phorton1/Arduino-wireStripper32/docs/design.md

# wireStripper32 - Design

**[Home](readme.md)** --
**Design** --
**[Electronics](electronics.md)** --
**[Build](build.md)** --
**[Firmware](firmware.md)** --

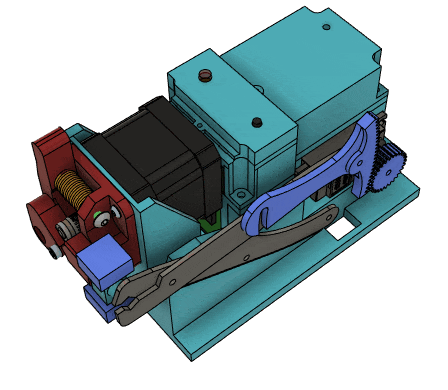
[picture p2: docs/images/design_anim1.gif]
design_anim1


**Next:** A look at the [**Electronics**](electronics.md) for the machine ...
