phorton1/Arduino-wireStripper32/docs/electronics.md

# wireStripper32 - Electronics

**[Home](readme.md)** --
**[Design](design.md)** --
**Electronics** --
**[Build](build.md)** --
**[Firmware](firmware.md)** --

This page shows all of the schematics, PCB designs, and has
photos of the completed circuit boards used in the wireStripper.
Please see the **/docs/kicad** folder for the actual schematics
and PCB designs.

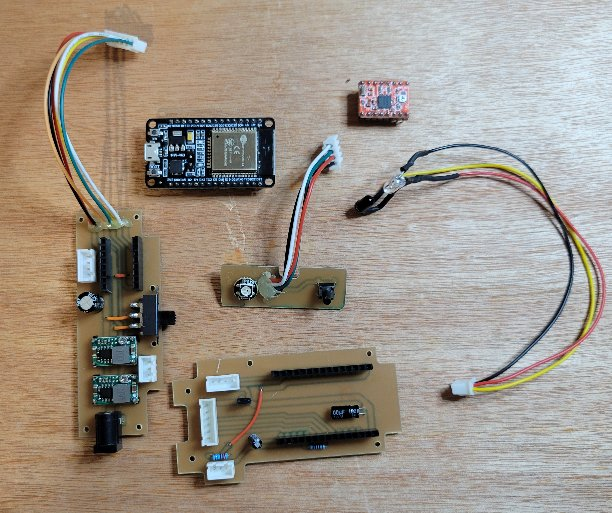
[picture p3: docs/images/electronics.jpg]


## The Power Board

The *Power Board* takes a **12V DC** input and has two **buck converters* on it.
One buck converter produces **7V DC** (the maximum rated voltage) for the
Servo and the other convertor produces **5V** DC to go to the ESP32.
The Power Board has a **scocket** for the *A4988 stepper motor controller**,
and **plugs** for the *Nema17 stepper motor* and *MG995 Servo*.
The Power Board connects to the Main Board with a **6 pin cable** that
caries GND, 5V, the **Enable, Step, and Direction** signals for
the stepper motor, and the PWM signal for the *Servo*.

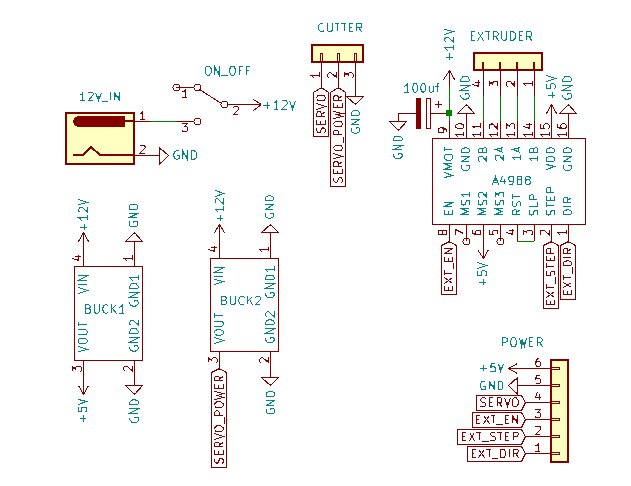
[picture p4: docs/images/elec_power_schematic.jpg]

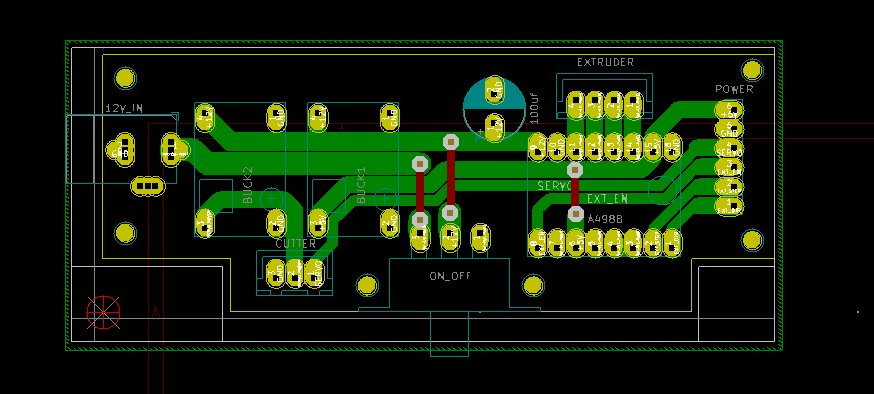
[picture p5: docs/images/elec_power_pcb.jpg]

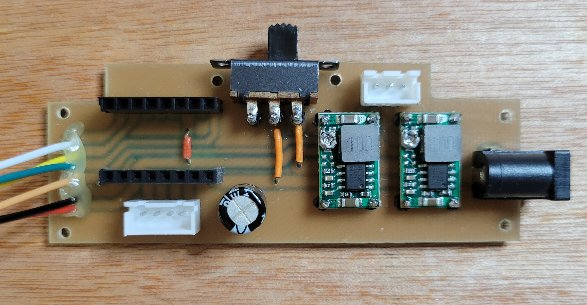
[picture p6: docs/images/elec_power_front.jpg]

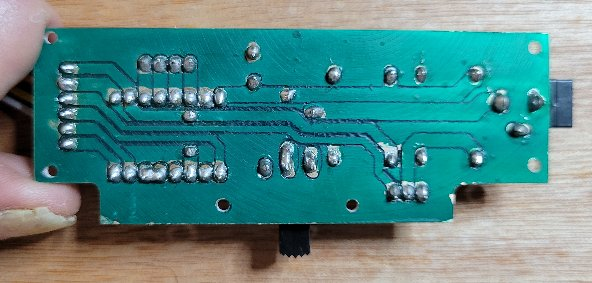
[picture p7: docs/images/elec_power_back.jpg]


## The Main Board

The *Main Board* has a **socket** for the ESP32 dev board, and
**plugs** to connect it to the *Power Board*, the *IR Sensor*
LEDs, and the **UI Board**.   It also has a **jumper** that
allows the ESP32 to connect the **5V** from Power Board to the
*VIN pin* on the ESP32, along with a 100uf capacitor to smooth
out the 5V VIN power supply

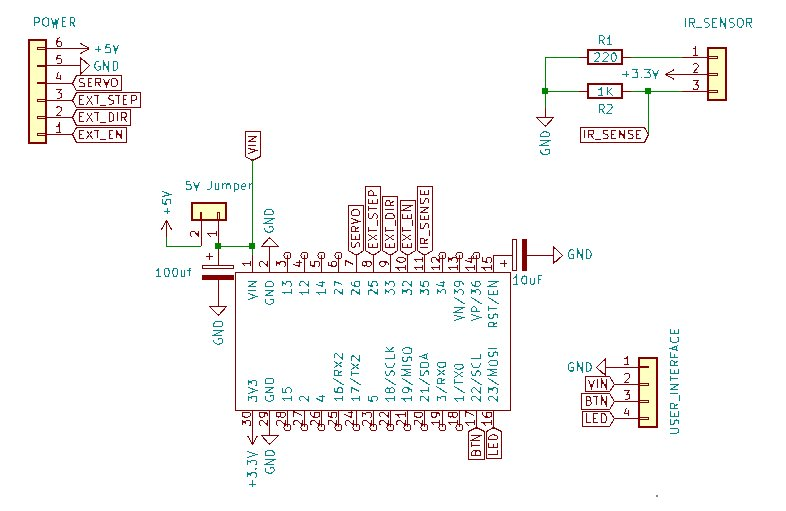
[picture p8: docs/images/elec_board_schematic.jpg]

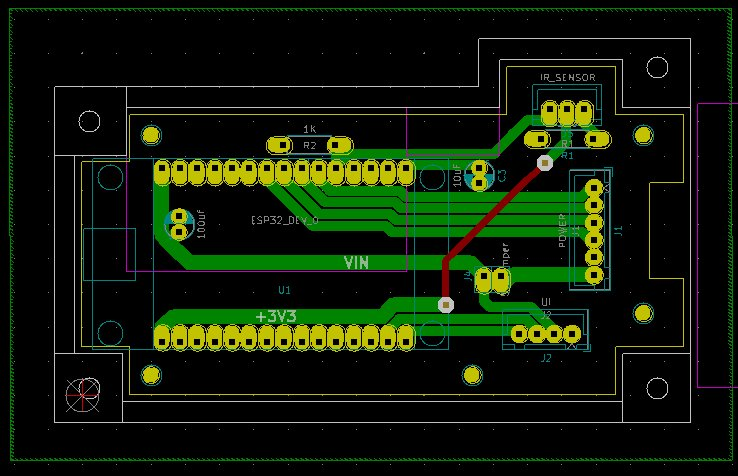
[picture p9: docs/images/elec_board_pcb.jpg]

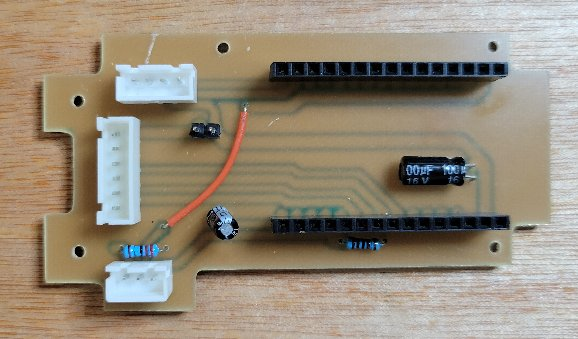
[picture p10: docs/images/elec_board_front.jpg]

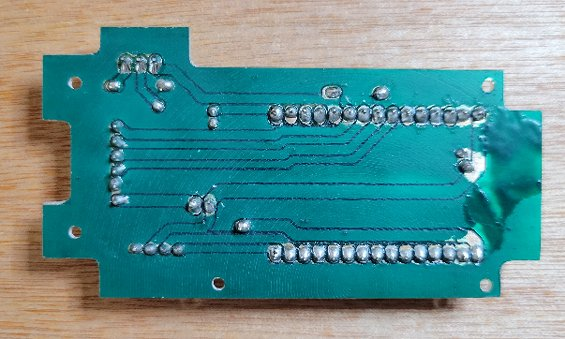
[picture p11: docs/images/elec_board_back.jpg]


## The UI (User Interface) Board

The UI board simply has a **push button** and a **WS2812b LED**
on it, along with a cable that reaches to the Main Board.

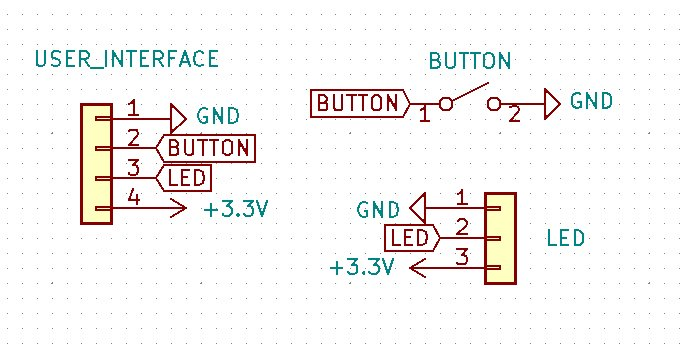
[picture p12: docs/images/elec_ui_schematic.jpg]

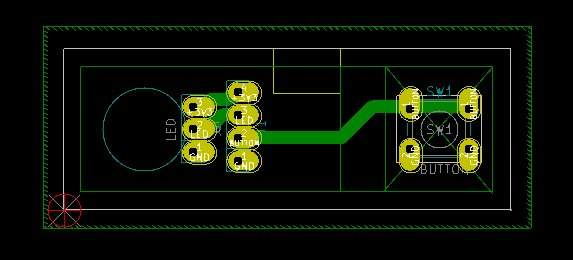
[picture p13: docs/images/elec_ui_pcb.jpg]

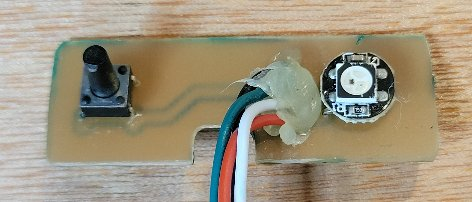
[picture p14: docs/images/elec_ui_front.jpg]

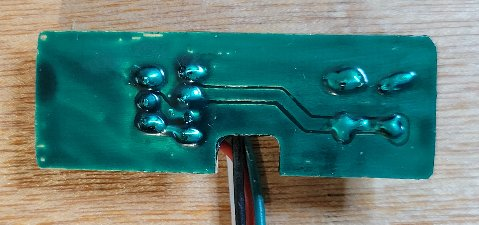
[picture p15: docs/images/elec_ui_back.jpg]


I used a 9mm circular WS2812b breakout board for the LED:

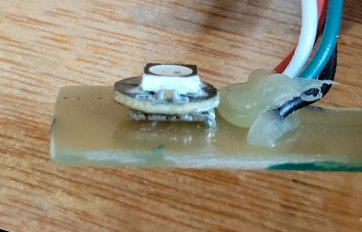
[picture p16: docs/images/elec_led_detail.jpg]


## The IR Sensor

The IR Sensor merely consists of an **850nm** *LED* (clear)
and *sensor* (black), soldered directly to a 3 pin JST wire
header with some heat shrink tubing.

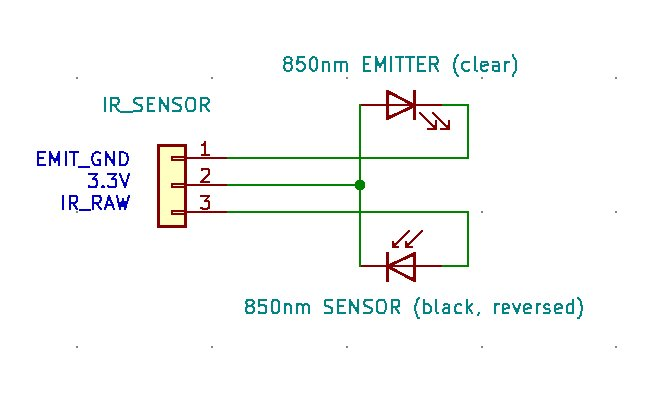
[picture p17: docs/images/elec_ir_schematic.jpg]

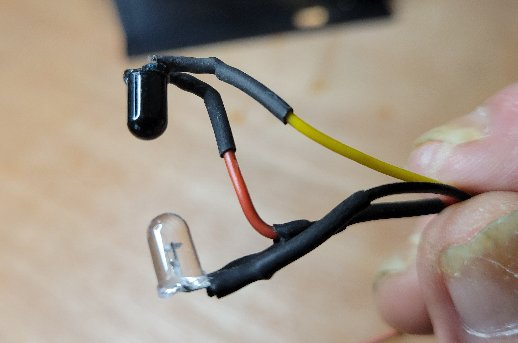
[picture p18: docs/images/elec_ir_sensor.jpg]


The key is that the **LED is wired normally** with the anode
(the long leg) to the 3.3V power supply, but **the Sensor is
wired backwards** with the cathode (the short leg) connected
to the 3.3V power supply.

## Other Cables/Connectors

I also put a 4-pin JST connector on the end of a short standard
stepper motor cable,

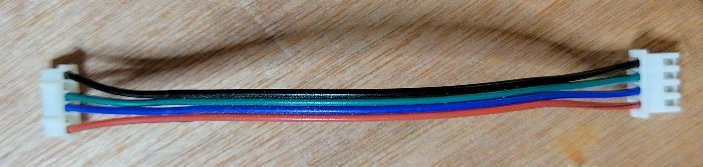
[picture p19: docs/images/elec_stepper_cable.jpg]


and added a 3-pin JST connector to the (shorted) cable on the
Servo.

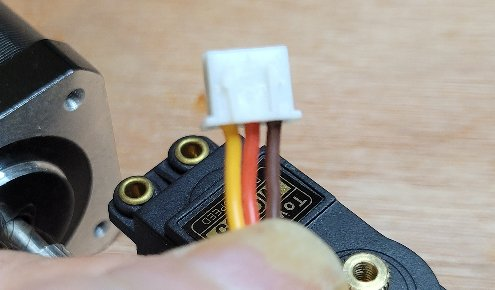
[picture p20: docs/images/elec_servo_connector.jpg]


**Next:** - [**Building**](building.md) the wireStripper ..
