phorton1/Arduino-wireStripper32/docs/fusion/lens.stl

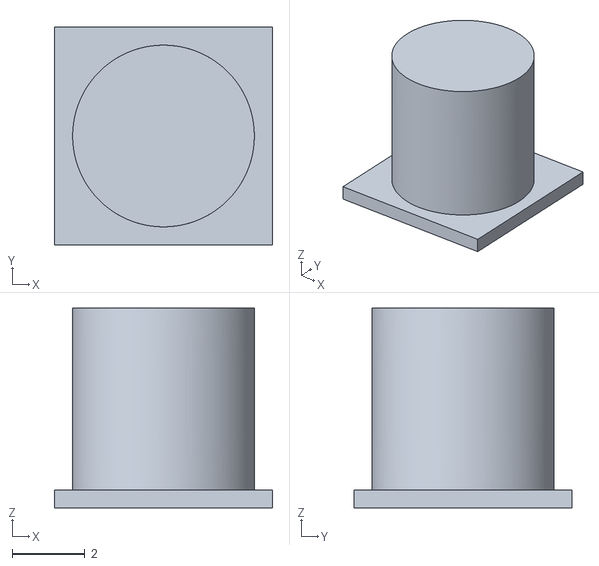
[picture p21: CAD file, 2024-07-24]
docs/fusion/lens.stl
6.00 x 6.00 x 5.50
