phorton1/Arduino-wireStripper32/docs/kicad/ui_board/ui_board.step

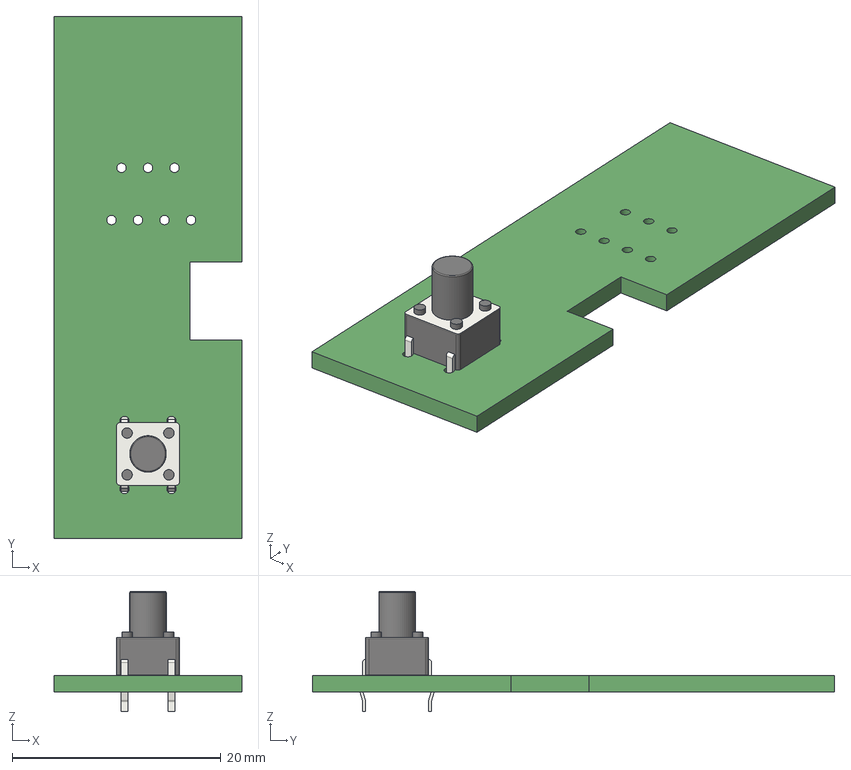
[picture p22: CAD file, 2024-07-24]
docs/kicad/ui_board/ui_board.step
18.0 x 50.0 x 11.5 mm
