phorton1/Arduino-wireStripper32/docs/prusa/top.3mf

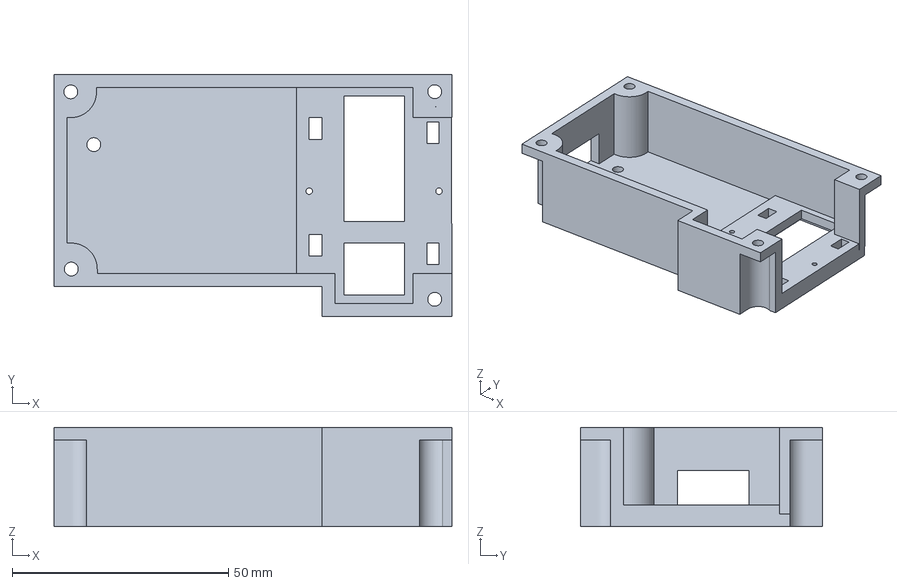
[picture p23: CAD file, 2024-07-24]
docs/prusa/top.3mf
92.0 x 56.0 x 23.0 mm
