phorton1/Arduino-wireStripper32/docs/fusion/frame.stl

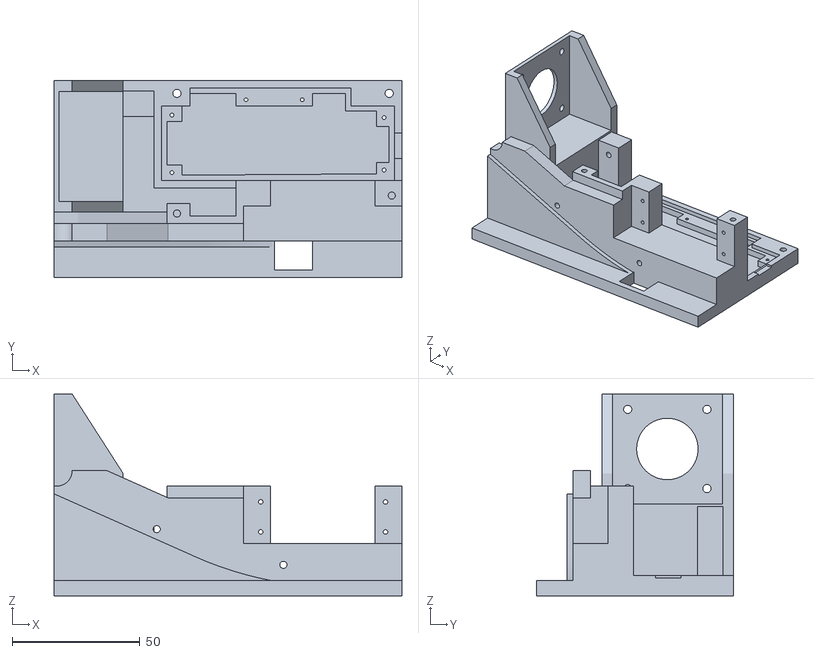
[picture p24: CAD file, 2024-07-24]
docs/fusion/frame.stl
136.1 x 77.0 x 79.0
