phorton1/Arduino-wireStripper32/docs/prusa/ui_top.3mf

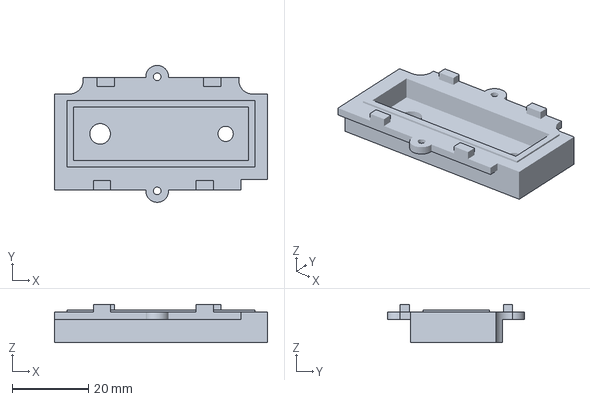
[picture p25: CAD file, 2024-07-24]
docs/prusa/ui_top.3mf
56.0 x 35.9 x 10.0 mm
