phorton1/Arduino-wireStripper32/docs/fusion/cap.stl

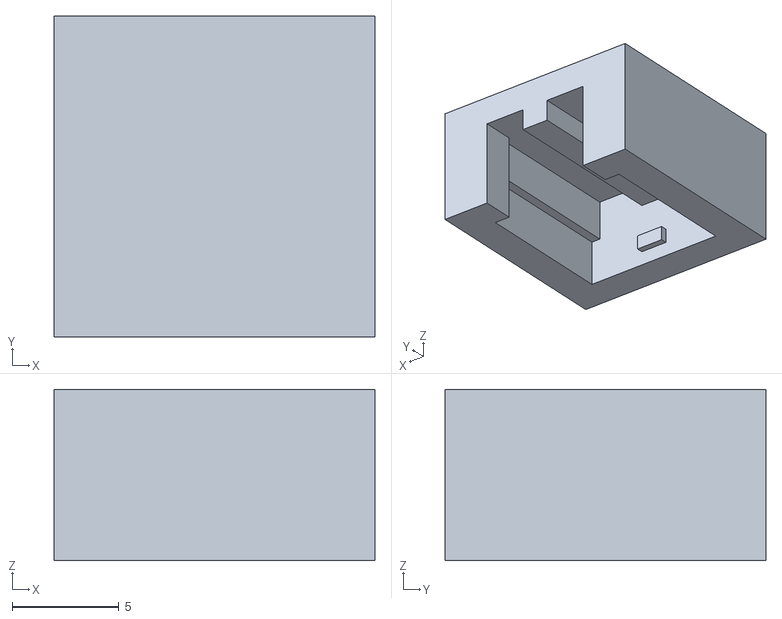
[picture p26: CAD file, 2024-07-24]
docs/fusion/cap.stl
15.0 x 15.0 x 8.00
