phorton1/Arduino-wireStripper32/docs/fusion/gear2.stl

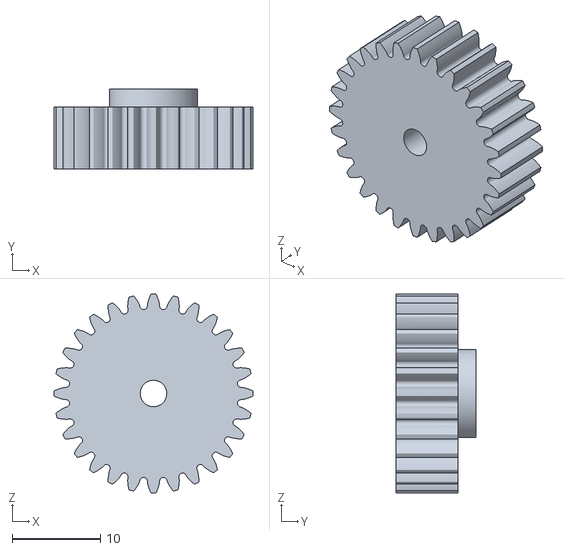
[picture p27: CAD file, 2024-07-24]
docs/fusion/gear2.stl
22.5 x 9.00 x 22.5
