phorton1/Arduino-wireStripper32/docs/prusa/lens.3mf

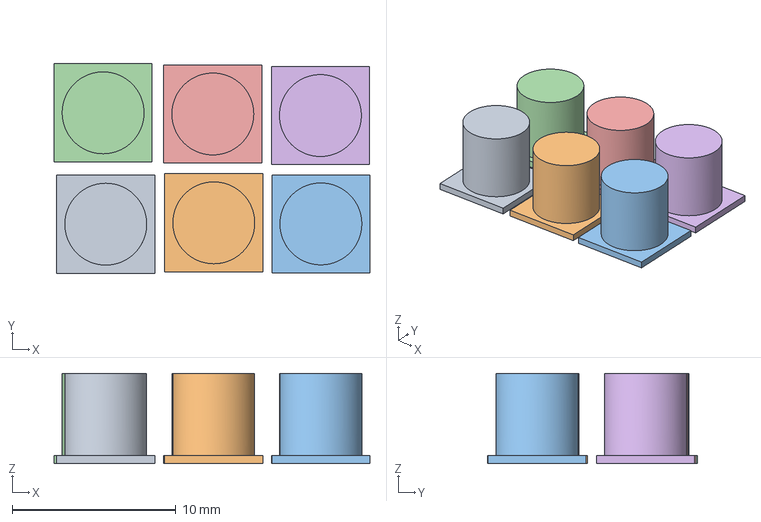
[picture p28: CAD file, 2024-07-24]
docs/prusa/lens.3mf
19.3 x 12.8 x 5.50 mm
lens.stl x 6
