phorton1/Arduino-wireStripper32/docs/fusion/middle.stl

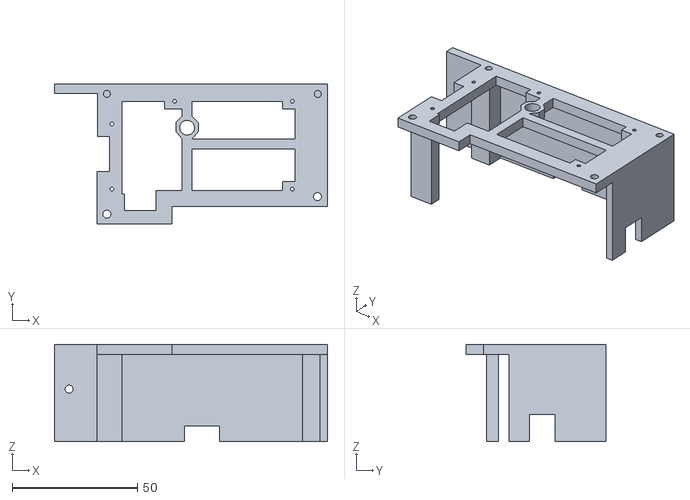
[picture p29: CAD file, 2024-07-24]
docs/fusion/middle.stl
108.9 x 56.0 x 38.8
