phorton1/Arduino-wireStripper32/docs/prusa/gear1.3mf

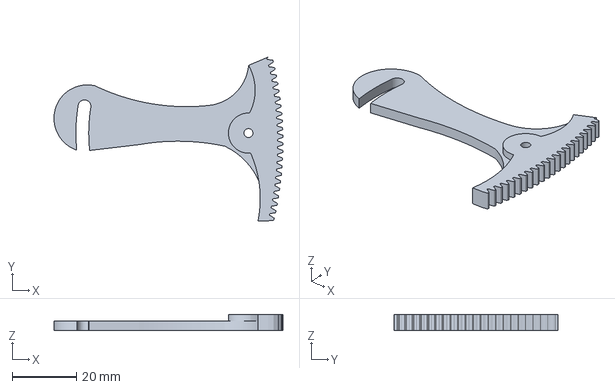
[picture p30: CAD file, 2024-07-24]
docs/prusa/gear1.3mf
71.5 x 51.1 x 5.00 mm
