phorton1/Arduino-wireStripper32/docs/prusa/cap.3mf

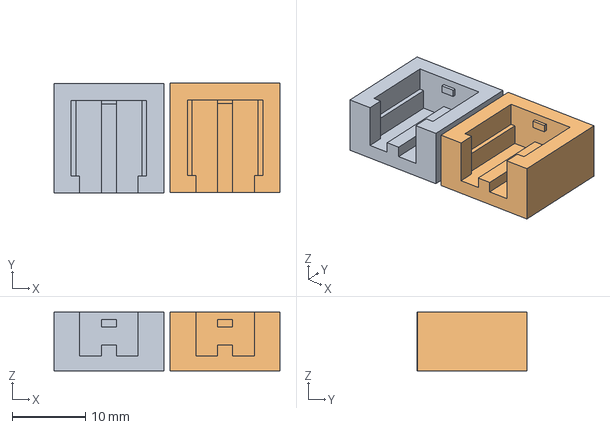
[picture p31: CAD file, 2024-07-24]
docs/prusa/cap.3mf
30.9 x 15.1 x 8.00 mm
cap.stl x 2
