phorton1/Arduino-wireStripper32/docs/prusa/nozzle.3mf

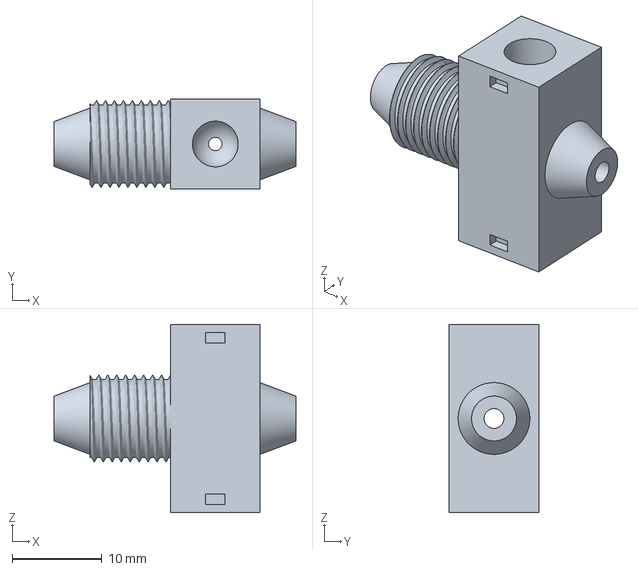
[picture p32: CAD file, 2024-07-24]
docs/prusa/nozzle.3mf
27.0 x 10.0 x 21.0 mm
