phorton1/Arduino-wireStripper32/(list of files, cad)

Other CAD files:
docs/prusa/frame.3mf
docs/fusion/gear1.stl
docs/fusion/ui_top.stl
docs/prusa/gear2.3mf
docs/fusion/top.stl
docs/fusion/nozzle.stl
docs/prusa/middle.3mf
