phorton1/Arduino-wireStripper32/docs/build.md

# wireStripper32 - Building the wireStripper

**[Home](readme.md)** --
**[Design](design.md)** --
**[Electronics](electronics.md)** --
**Build** --
**[Firmware](firmware.md)** --

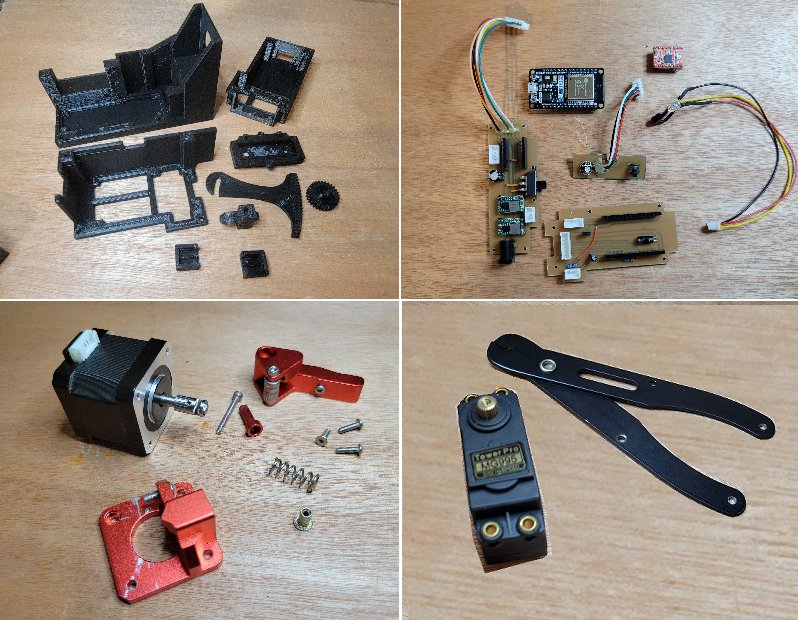
[picture p33: docs/images/build_combined.jpg]


**Next:** Installing the **[Firmware](firmware.md)** and testing the PCB ...
