phorton1/Arduino-wireStripper32/docs/kicad/power/power.kicad_pcb

## KiCad design docs/kicad/power/power.kicad_pcb (2024-07-27)

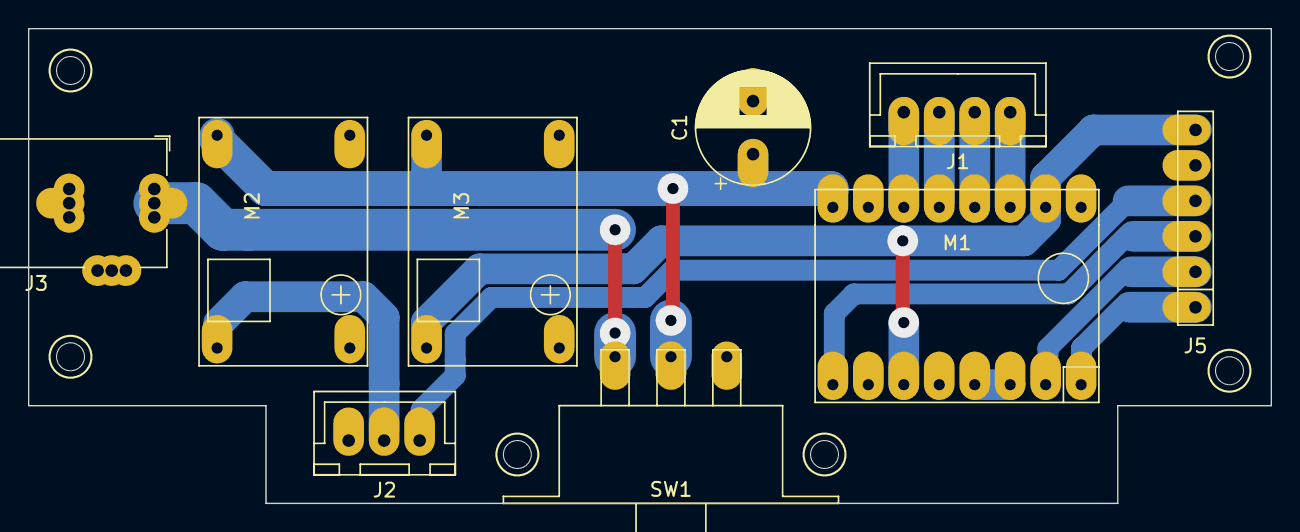
[picture p34: board power.kicad_pcb from above]

Board: 2 copper layers, 89.0 x 34.0 mm, 9 parts (0 on the bottom side), 14 nets.

Parts:
C1: 100uf; CP_my100uf
J1: EXTRUDER; JST4
J2: CUTTER; JST3
J3: 12V_IN; myBarrelJack
J5: POWER; myPinSocket_1x06
M1: A4988; a498
M2: BUCK2; buck-mini360
M3: BUCK1; buck-mini360
SW1: ON_OFF; slide_switch_big_right

Connections:
+5V: J5.6, M1.6, M1.15, M3.3
+12V: C1.1, M1.9, M2.4, M3.4, SW1.2
EXT_DIR: J5.1, M1.1
EXT_EN: J5.3, M1.8
EXT_STEP: J5.2, M1.2
GND: C1.2, J2.3, J3.2, J5.5, M1.10, M1.16, M2.1, M2.2, M3.1, M3.2
unnamed: J1.1, M1.14
unnamed: J1.2, M1.13
unnamed: J1.3, M1.12
unnamed: J1.4, M1.11
unnamed: J3.1, SW1.3
unnamed: M1.3, M1.4
SERVO: J2.1, J5.4
SERVO_POWER: J2.2, M2.3
