phorton1/Arduino-wireStripper32/docs/kicad/ui_board/ui_board.kicad_pcb

## KiCad design docs/kicad/ui_board/ui_board.kicad_pcb (2024-07-27)

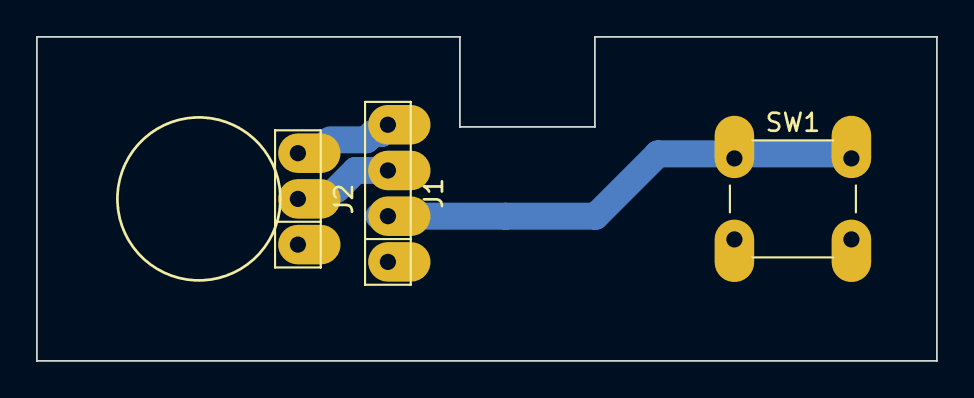
[picture p35: board ui_board.kicad_pcb from above]

Board: 2 copper layers, 50.0 x 18.0 mm, 3 parts (0 on the bottom side), 4 nets.

Parts:
J1: UI; my4pin
J2: LED; my3pin
SW1: BUTTON; SW_PUSH_6mm_H8mm

Connections:
+3V3: J1.4, J2.3
BUTTON: J1.2, SW1.1
GND: J1.1, J2.1, SW1.2
LED: J1.3, J2.2
