phorton1/Arduino-wireStripper32/docs/kicad/board/board.kicad_pcb

## KiCad design docs/kicad/board/board.kicad_pcb (2024-07-24)

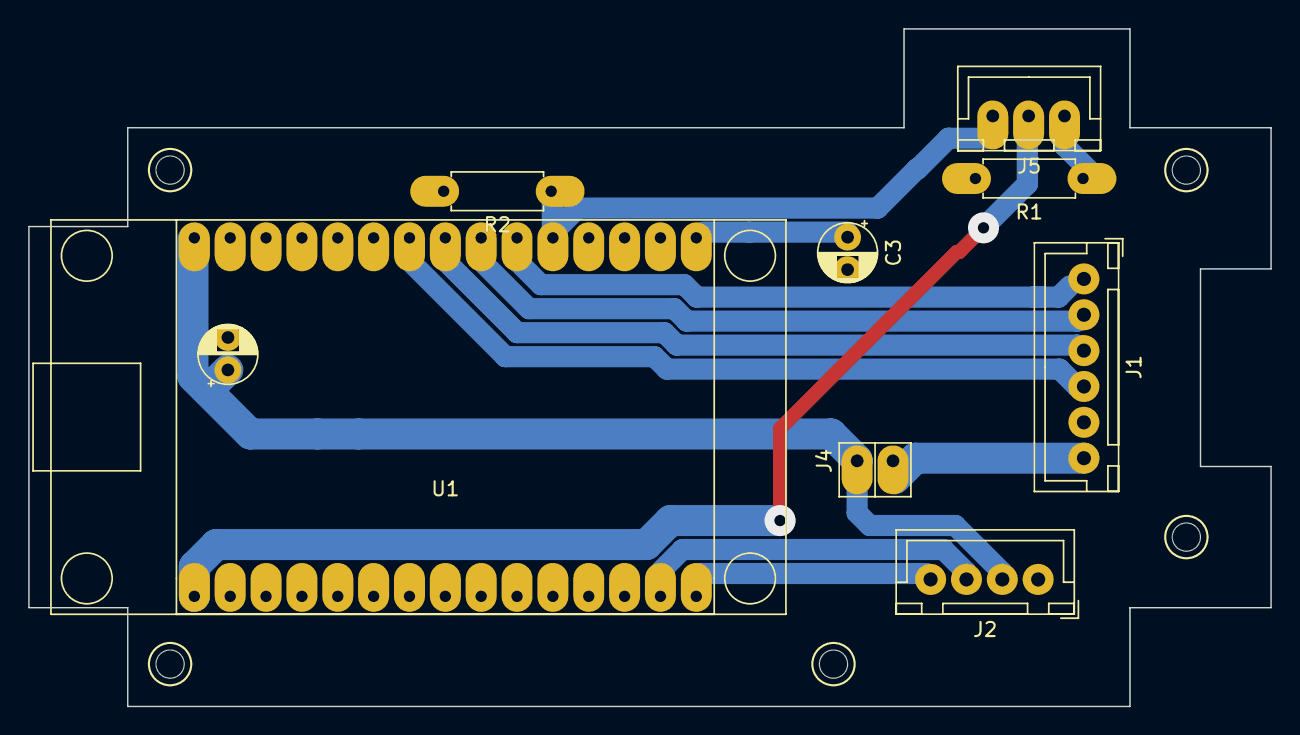
[picture p36: board board.kicad_pcb from above]

Board: 2 copper layers, 88.0 x 48.0 mm, 9 parts (0 on the bottom side), 13 nets.

Parts:
C2: 100uf; CP_my10uf
C3: 10uF; CP_my10uf
J1: POWER; myJSTx06
J2: UI; myJSTx04
J4: 5V Jumper; pinHeader1x2
J5: IR_SENSOR; JST3
R1: 220; resistor
R2: 1K; resistor
U1: ESP32_DEV_0; esp32_dev_0

Connections:
+3V3: J5.2, U1.30
+5V: J1.6, J4.2
BTN: J2.3, U1.17
EXT_DIR: J1.2, U1.9
EXT_EN: J1.1, U1.10
EXT_STEP: J1.3, U1.8
GND: C2.2, C3.2, J1.5, J2.1, R1.2, R2.2, U1.2, U1.29
IR_SENSE: J5.3, R2.1, U1.11
LED: J2.4, U1.16
unnamed: C3.1, U1.15
unnamed: J5.1, R1.1
SERVO: J1.4, U1.7
VIN: C2.1, J2.2, J4.1, U1.1
