phorton1/Arduino-wireStripper32/(commit log)

2024-07-24 initial commit new repo
    [board.kicad_pcb, board.sch, cap.3mf, cap.stl, frame.3mf, frame.stl, gear1.3mf, gear1.stl]
2024-07-24 a couple of initial doc images
2024-07-27 Docs mostly - intallable bin image - minor changes to board pcbs for presentation
    [board.sch, ir_sensor.sch, power.kicad_pcb, power.sch, ui_board.kicad_pcb, ui_board.sch]
2024-09-21 submodule(data) auto_commit(83767cf1) Added a Widget tab to the main myIOT webpage; added jqplot CSS and JS files; wrote iotPlot.js prototype of charting within a "widget" - see fridgeController chec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
2024-09-25 submodule(data) auto_commit(331f60b7) refined myIOT plotter with LEGENDS and using device specific PLOT_TYPES if available; theClock3 implementation of PLOT_CYCLES and PLOT_WAVES
2024-09-29 submodule(data) auto_commit(416ed000) added prototype bilgeAlarm jqPlot Widget using added "alt_data_format" and custom chart_header and chart_data code in onCustomLink(). modified myIOT/data index.h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
2024-10-21 submodule(data) auto_commit(b811e3f8) move generic uiButtons to myIOTButtons; implement initial tempController uiScreen and PCB board(s)
2025-02-02 reburned ESP32 (usb port broke) setting current new defaults
    [wireStripper.cpp]
2025-12-15 submodule(data) auto_commit(b649fc3a) iotChart.js - added scheme for setting device specific series colors
2025-12-18 submodule(data) auto_commit(1adaeb45) reworked iotChart.js incremental update scheme starting with Arduino-boat-drainPump
2025-12-18 submodule(data) auto_commit(b6ac0c88) starting in Arduino-boat-arirco, major rework of iotChart.js and how charts are implemented - use common chart.html instead of specific/extra_data/device_chart.h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
2025-12-18 submodule(data) auto_commit(a4e2ed81) change chart.html and iotChart.js to use and remove style "degree_hidden" for devices that chart things with degrees
2026-02-22 submodule(data) auto_commit(37a6a76c) added framework for chart.html to pass "data_name" to allow multiple charts per device; ALSO store most recent chart period in browser storage
2026-03-05 submodule(data) auto_commit(ecc76888) update myIOT data submodule readme.md to remove forward references to actual implmented device repos
2026-04-04 submodule(data) auto_commit(de0689cf) disable Scan/Delete endpoints and just View data records for devices that have graphs, but no SD card
2026-06-28 submodule(data) auto_commit(eadab9ea) added myIOTDataLog type LOG_COL_TYPE_INT16_10 to support volts (fridgeController)
2026-09-11 submodule(data) auto_commit(6700b423) skip sample points with temperature sensor anomolies
